fabiankung/MMU_FOE_Sensor_Node/README.md

# MMU_FOE_Sensor_Node
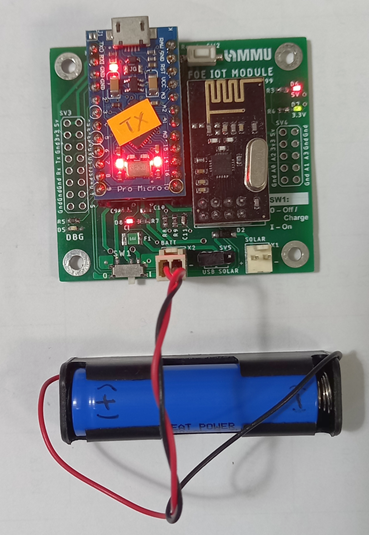
[picture p1: SensorNode_V0_99.bmp]
Sensor Node


A small sensor node design based on Arduino by Faculty of Engineering, Multimedia University.
Please go the the /Hardware_Build folder for the design details and also the quick start guide.
