fabiankung/MMU_FOE_Sensor_Node/Hardware_Build/V0_99/BOM_V0_99.xlsx

Bill Of Materials
Design Title |  |  | FOE IOT Node (Beta)
Author
Document Number
Revision |  |  | 0.99
Design Created
Verify |  |  | F.Kung
 | Components need to order
Category | Quantity | References | Value | Remarks/Description | Stock Code | Supplier | PCB Package
IC | 1 | U1 | MIC2288 | 2.5V-10Vin, 3.6V-34Vout, 1Aout, DC-DC regulator | 2509929 | Element14 | SOT-23-5 | Can replace with AP1603WG-7
Inductor | 1 | L1 | 4.7uH | 1.35A, Shielded power inductor | 3585795 | Element14 | 3x3 mm
Capacitor | 5 | C1, C5, C6, C9, C10 | 10uF | 6.3V, +-20% Multilayer ceramic | 3216467 | Element14 | 0603
Capacitor | 1 | C2 | 22uF | 6.3V, +-20% Multilayer ceramic | 2494232 | Element14 | 0603
Capacitor | 5 | C3, C4, C7, C8, C11 | 0.1uF | 50V, 10% Multi-layer ceramic | 2146610 | Element14 | 0603
Diodes | 3 | D1, D2, D3 | PMEG3010 | 30V, 1A Schottky rectifier | 2498556 | Element14 | SOD-993
Diodes | 1 | D4 | MMSZ5234BT1G | 6.2V, 500mW, 5% Zener single diode | 1431276 | Element14 | SOD-123
Resistor | 1 | R1 | 5.62k | 1%, 100mW, SMD Chip Resistor | 3540041 | Element14 | 0603
Resistor | 1 | R2 | 1.87k | 1%, 100mW, SMD Chip Resistor | 2694757 | Element14 | 0603
Resistor | 2 | R3, R7 | 4.7k | 1%, 62.5mW, thick film | 2447187 | Element14 | 0603
Resistor | 1 | R4 | 1.0k | 5%, 125mW, thick film | 9330380 | Element14 | 0603
LED | 1 | LED1 | 5V Red | Generic ultra bright LED | 2290329 | Element14 | 0603
LED | 1 | LED2 | 3V3 Green | Generic ultra bright LED | 8529833 | Element14 | 0603
IC | 1 | U2 | BU33TD3WG-TR | LDO voltage regulator, 1.7V to 6V input, fixed output 3.3 V/ 200mA | 2342950 | Element14 | SSOP5
IC | 1 | U3 | MCP73831T-2ATI/OT | Battery charger for a cell of Li-Ion | 1834890 | Element14 | SOT-23-5
Battery | 1 |  | 3.7V, 600mAh, 14500 | Li-Ion battery, 14500 size | LI-14500-600 | Cytron | NA
Solar panel | 1 |  | 5V, 200mA (1W) | THIS IS OPTIONAL | SC-05V-200MA | Cytron | NA
Resistor | 1 | R6 | 6.8k | 5%, 250mW, thick film | 1128052 | Element14 | 0603
Resistor | 2 | R8, R9 | 10k | 1%, 0.05W, thick film | 2349889 | Element14 | 0603
Fuse | 1 | F1 | 16V, 0.5A | Resettable PTC | 2848519 | Element14 | SMD
LED Products | 1 | Cl | 5V Red | Generic ultra bright LED | 2290329 | Element14
Pin Header | 1 | SV5 | NA | Straight Pin Header, Single Row (Male) | CN-PH-M140S | Cytron | 2.54mm
Switch | 1 | SW1 | SPDT switch | Slide Switch, SPDT, Surface Mount | 2854773 | Element14 | CUS-12B
Module | 1 | M1 | NA | Arduino Pro-Micro | ARD-PRO-MICROC | Cytron | NA
Pin Header | 1 | SV3, SV4 | NA | Straight Pin Header, Double Row (Male) | CN-PH-M240S | Cytron | 2.54mm
Female Header | 1 | SV1 | NA | Straight Female Header, Double Row | CN-PH-F210S | Cytron | 2.54mm
Connector | 2 | X1, X2 | NA | PCB Connector Header 2 Ways | CN-2600PS-02 | Cytron | 2.54mm
Resistor | 1 | R5 | 2.2k | 1%, 100 mW, thick film | 9330810 | Element14 | 0603
LED | 1 | DBG Blue | Blue | 20mA, 3.3 V, 465nm | 2217972 | Element14 | 0603
Module | 1 | nRF24L01+ | NA | 2.4GHz Digital Radio | RF-TRX-2.4G | Cytron | NA
 |  |  |  |  |  |  | Total
