fabiankung/MMU_FOE_Sensor_Node/Hardware_Build/V0_99/Schematic 0.99.pdf

A

A

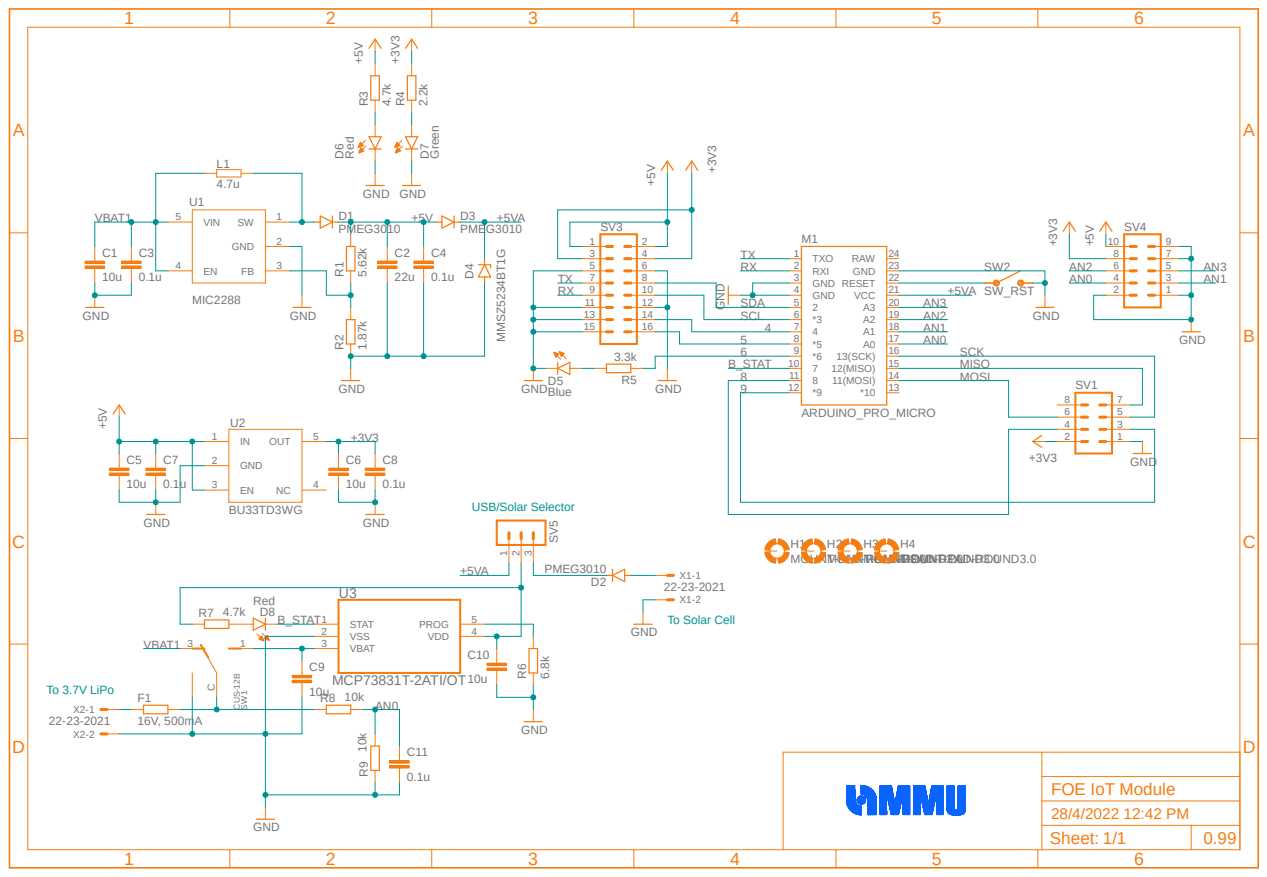
[picture p2: page 1]

15 | | 4 7 | ARDUINO_PRO_MICRO GND

13 | 14 | SCL
