fabiankung/MMU_FOE_Sensor_Node/Hardware_Build/Readme.md

## Sensor Node Schematic and PCB 
- Version: 0.99
- Date of design buy-off: 29 April 2022
- First batch build: 31 May 2022
