fabiankung/MMU_FOE_Sensor_Node/Hardware_Build/V0_99/PCB 0.99.docx

Top Copper

Bottom Copper

Silkscreen

Specify location for manufacturer order number. Or pay extra USD1.70 to remove it.

Dimension
