fabiankung/MMU_FOE_Sensor_Node/Hardware_Build/V0_99/QuickStartGuide.pdf

# FOE SENSOR NODE

# Version 0.99 (Initial Release A)

# QUICK START GUIDE (REV A0)

22/5/2023 | 1

# Simplified Block Diagram (V0.90 and V0.99)

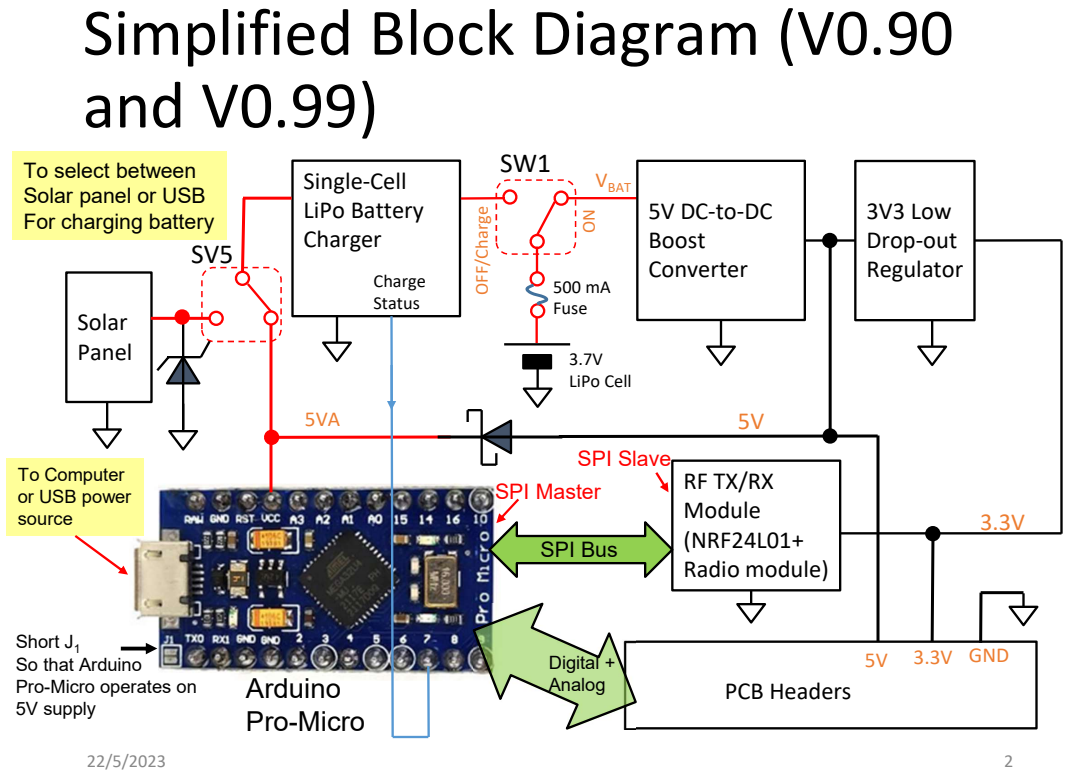
[picture p3: page 2]
Single-Cell LiPo Battery Charger; 3V3 Low Drop-out Regulator; 3.7V LiPo Cell; PCB Headers; Solar Panel; 5V 3.3V GND; SPI Bus; SPI Master; SPI Slave; Digital + Analog; 500 mA Fuse; Charge Status; Arduino Pro-Micro

SW1 ON OFF/Charge

To select between
Solar panel or USB
For charging battery

VBAT
Boost
Converter

To Computer
or USB power
source

Module
(NRF24L01+
Radio module)

Short J1
So that Arduino
Pro-Micro operates on
5V supply

# Features

- Arduino based (Arduino Pro-Micro).
- Low power, 3.0 to 12.0 V input voltage to power the device.

# - 4 Analog and 5 digital I/O pins, with 5V and 3.3V supply for interfacing with various sensors (Note: Analog pin A0 is used

for monitoring input supply voltage).

# - Secure 2.4 GHz RF link between sensor nodes and a Master

node cum Internet gateway (10-20m).

# - Rechargeable lithium polymer (LiPo) battery, battery can be

charged via micro-USB receptable or optional solar panel.

22/5/2023 | 3

# Specifications

- Main Controller: Arduino Pro-Micro.

# - Wireless Module: NRF24L01+ digital radio, 0.0 dBm

EIRP with 2 Mbps data rate using GMSK modulation, 2.400-2.4835 GHz ISM band.
- Analog input pins rating: 0-5V.
- Digital input/output pins: 0-5V, 25 mA source/sink.
- Battery: Rechargeable 3.7V LiPo cell, 100 - 1500 mAH.
- Charging options: Micro-USB port or Solar Panel.
- Indicators: Debug LED, 5V supply LED, 3.3V supply LED.

# - Dimensions: 55 x 50 x 20 mm

22/5/2023 | 4

Gaussian Minimum Shift Keying (a variant of FSK with no phase discontinuity)

# Detailed Schematic

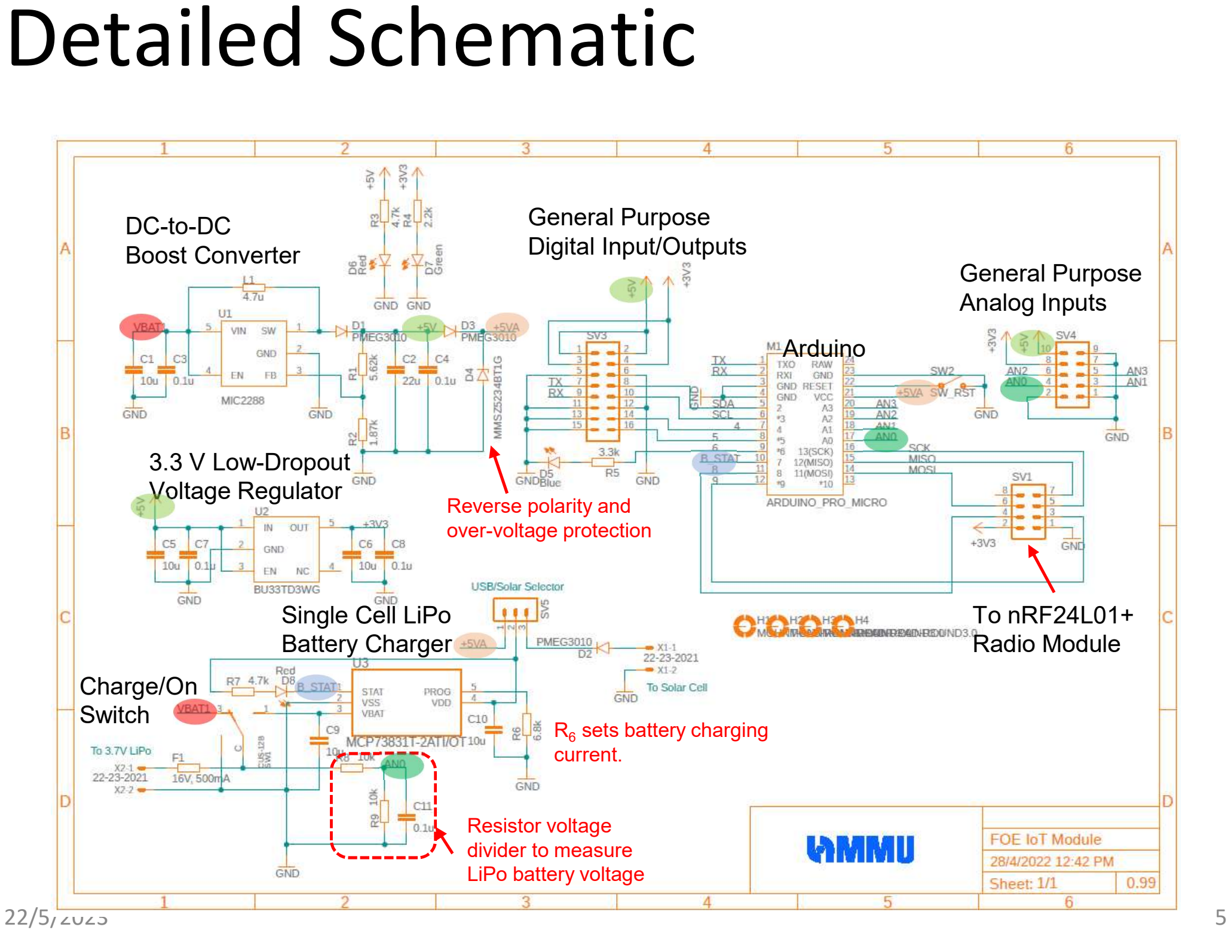
[picture p4: page 5]

22/5/2023 | 5

DC-to-DC
Boost Converter

### 3.3 V Low-Dropout

Voltage Regulator

Single Cell LiPo
Battery Charger
Charge/On
Switch

To nRF24L01+
Radio Module

Arduino

Resistor voltage
divider to measure
LiPo battery voltage

R6

sets battery charging
current.

Reverse polarity and
over-voltage protection

General Purpose
Analog Inputs

General Purpose
Digital Input/Outputs

# A Fully-Assembled Board

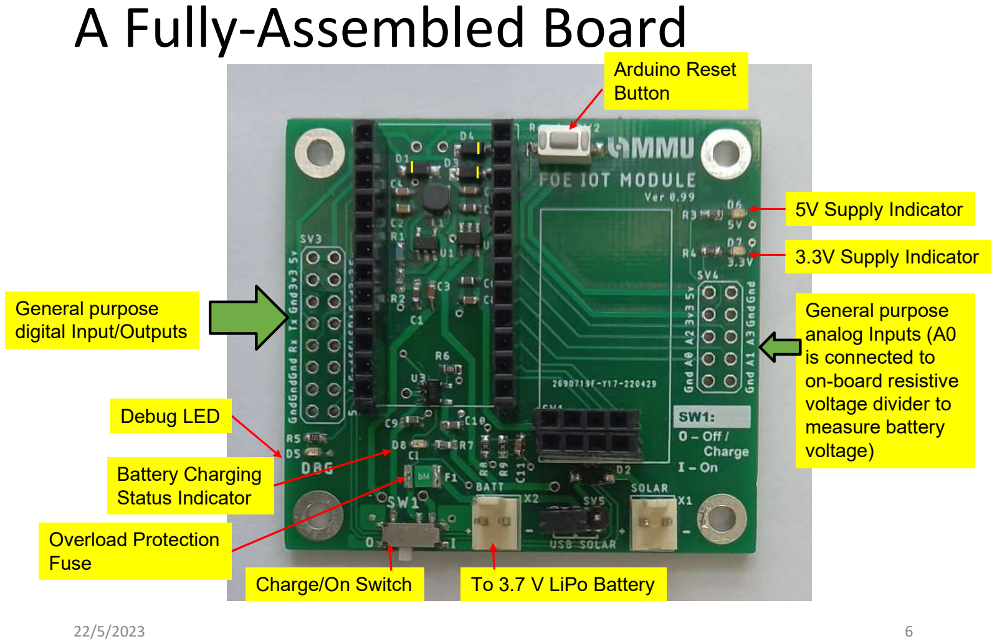
[picture p5: page 6]

22/5/2023 | 6

Arduino Reset
Button

Charge/On Switch To 3.7 V LiPo Battery

Debug LED

5V Supply Indicator

3.3V Supply Indicator

Battery Charging
Status Indicator

Overload Protection
Fuse

General purpose
analog Inputs (A0
is connected to
on-board resistive
voltage divider to
measure battery
voltage)

General purpose
digital Input/Outputs

# Fully Assembled Board with Arduino Pro-Micro and nRF24L01+ Radio

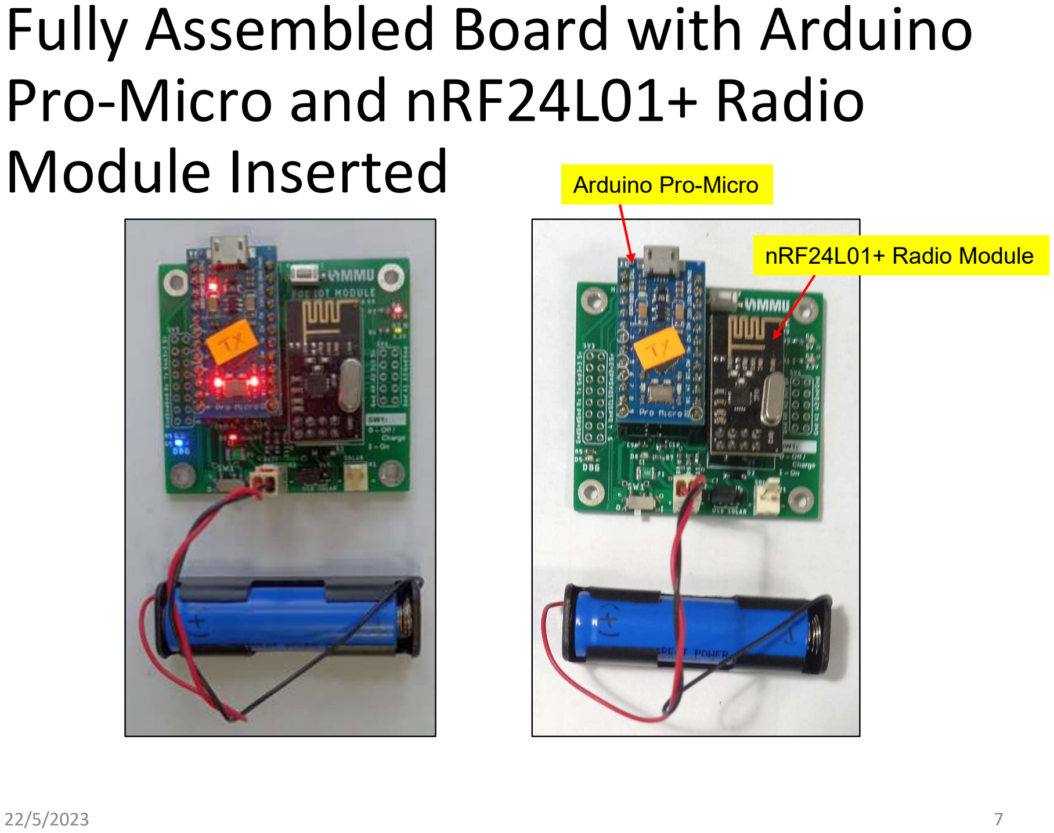
[picture p6: page 7]

# Module Inserted

22/5/2023 | 7

Arduino Pro-Micro

nRF24L01+ Radio Module

# Normal Operation (On)

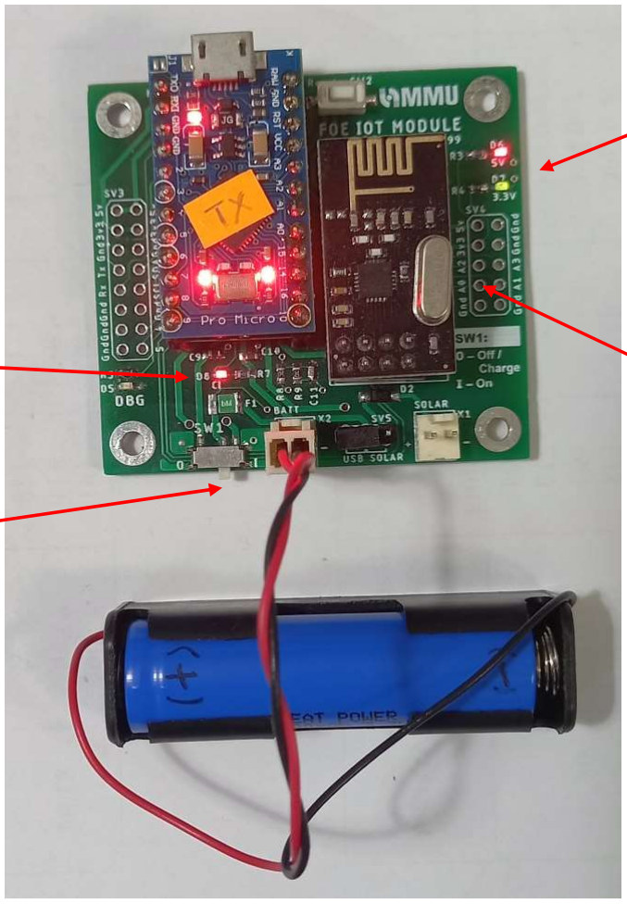
[picture p7: figure]

22/5/2023 | 8

Both supply indicator
LEDs should light up

Analog pin A0 indicates battery Voltage level via a divide-by-2 Resistor network.
For example if battery voltage is

### 3.7 V, pin A0 voltage should be

1.85 V.

SW1 to ‘On’
position

Can ignore battery
charging status
Indicator during normal
operation

# Charging LiPo Battery Via USB Port

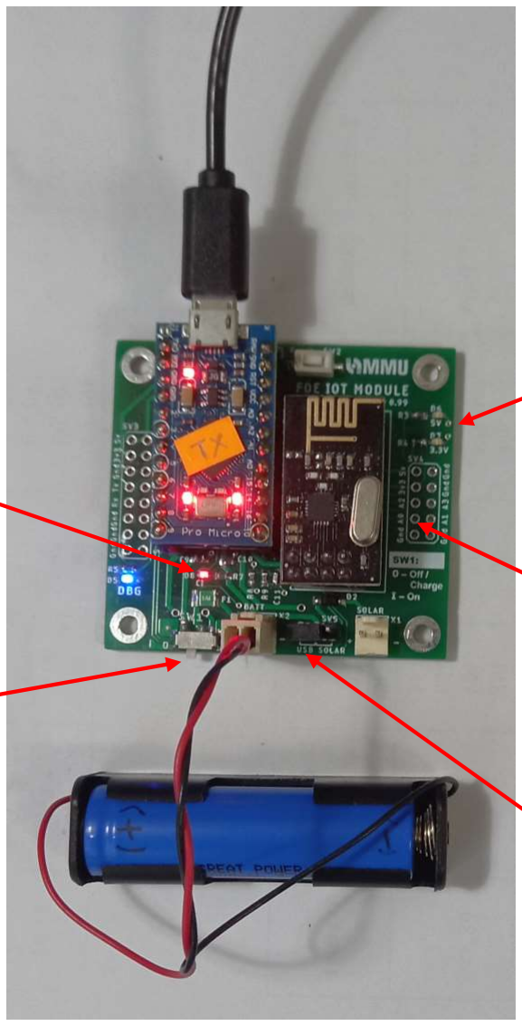
[picture p8: figure]

22/5/2023 | 9

Both supply indicator
LEDs should not light up

Analog pin A0 indicates battery Voltage level via a divide-by-2 Resistor network.
For example if battery voltage is

### 3.7 V, pin A0 voltage should be

1.85 V.

SW1 to ‘Off/Charge’
position

Battery
charging status
Indicator will lights up
during charging and
turned off when fully
Charged
(Max charging current is
200 mA)

Note the position of jumper SV5

# Charging LiPo Battery via Solar Panel

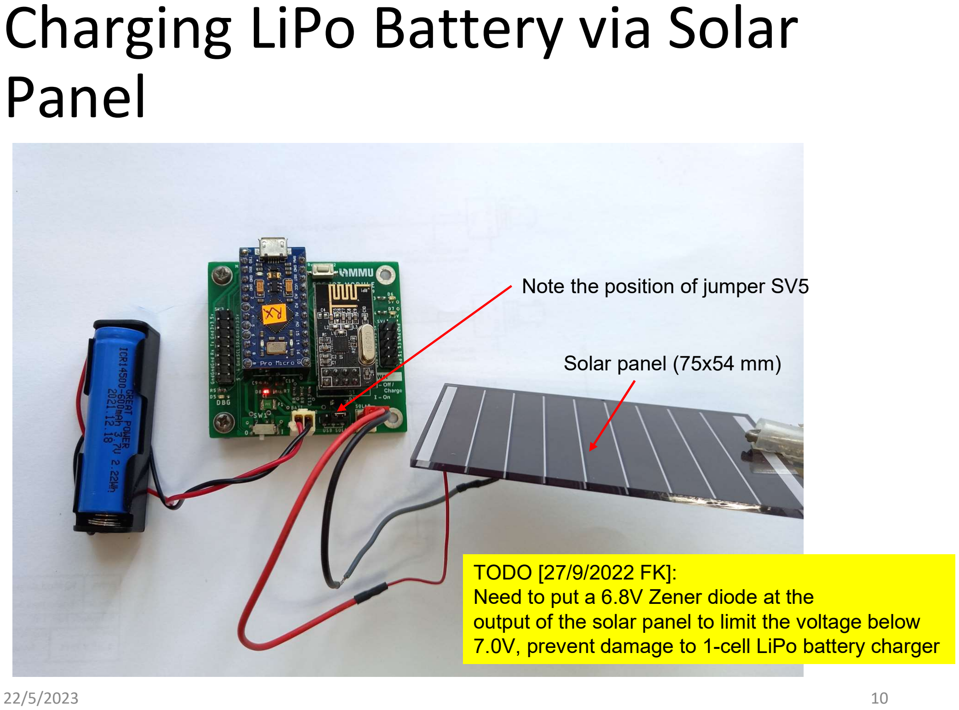
[picture p9: page 10]

22/5/2023 | 10

Note the position of jumper SV5

TODO [27/9/2022 FK]:
Need to put a 6.8V Zener diode at the
output of the solar panel to limit the voltage below 7.0V, prevent damage to 1-cell LiPo battery charger

Solar panel (75x54 mm)

# APPENDIX

22/5/2023 | 11

# Basic Functional Test for Newly Assembled PCB (1 off 2)

# - 1. Do not connect any wires or battery to the IOT

board.
- 2. Set Switch SW1 to “0 - Off/Charge” position.
- 3. Connect USB port of Arduino module to computer.

# - 4. Load the firmware “Wireless_TX_Basic.ino” into

the Arduino module.

# - 5. If the firmware is successfully loaded and IOT board no hardware error, LED “DBG” should blink at 2 Hz rate. Also LED D8

should lights up.

22/5/2023 | 12

# Basic Functional Test for Newly Assembled PCB (1 off 2)

# - 6. Now connect the LiPo battery to PCB header X2

(Batt),

# LED D8

# should continues to light up indicating that the LiPo

battery is being charged.
- 7.LED D8 would turn off when LiPo battery is fully charged.
- 8. Once the LiPo battery is partially charged for 15 minutes, set switch SW1 to “I – On” position.

# - LEDs 3.3 V (D7

# ) and 5.0 V (D6

# ) should light up, indicating presence

of 3.3 V and 5.0 V supplies to the system.
- LED “DBG” should continues to blink.

# - LED D8

should not turn on.
- 9. Now the IOT module should be ready for use.
22/5/2023 | 13

# Debug Tips

# - As the nRF24L01+ radio module does not have any indicator LED, we would need to probe it’s pin with digital oscilloscope to check if the Arduino is

communicating with the radio module.

# - Under normal operations:

- MOSI pin should be logic high.
- MISO pin should contain digital data.
- SCK pin should have burst of 8-pulses.
- CSN pin should alternate between logic high and low.
- CE pin should be logic high (enable the radio module).
22/5/2023 | 14

# nRF24L01 2.4 GHz Radio Chip

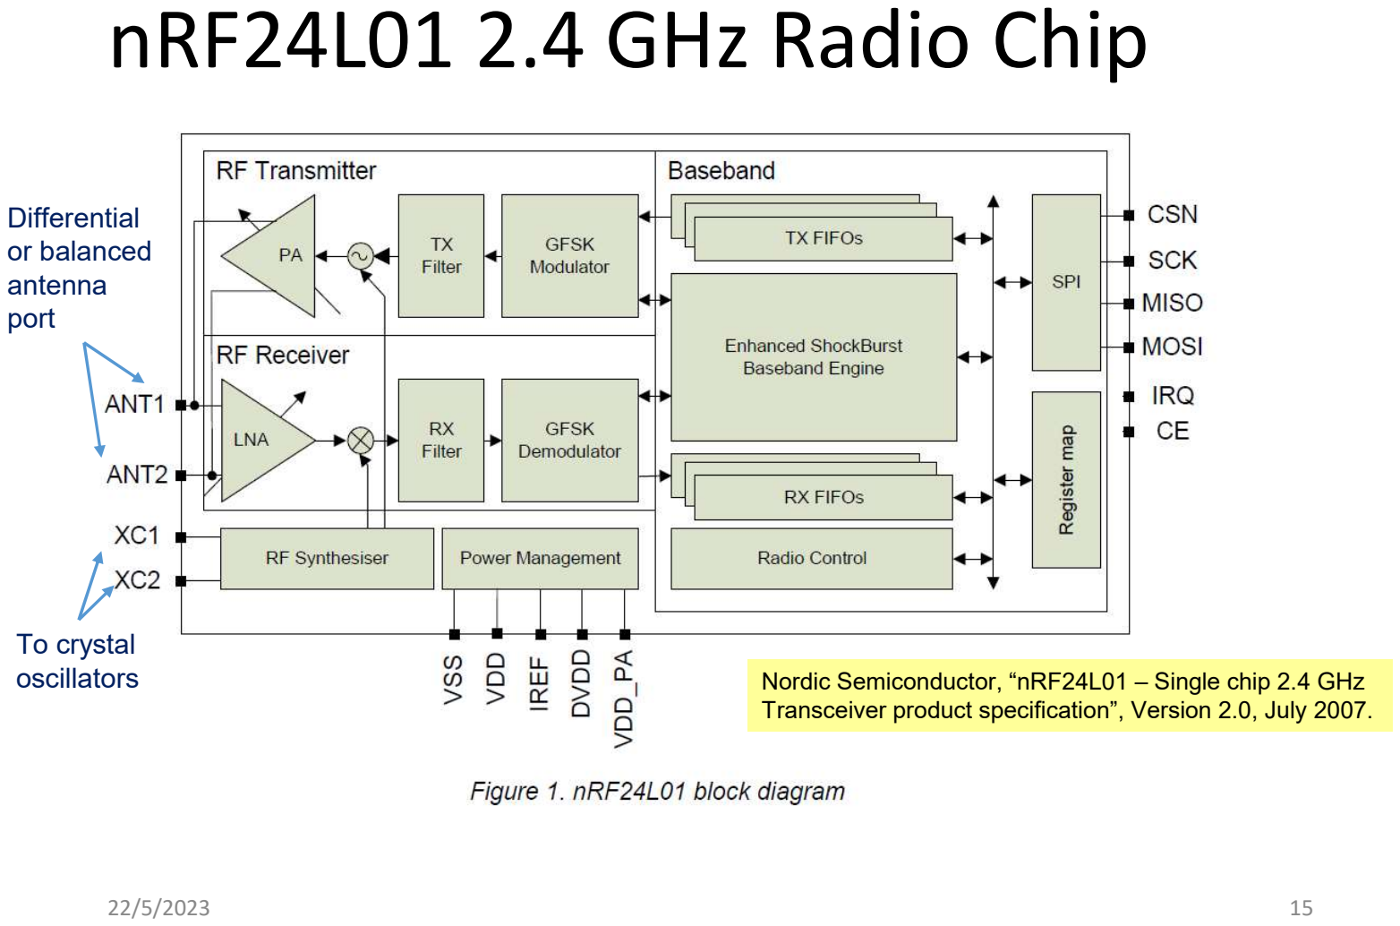
[picture p10: page 15]

22/5/2023 | 15

Nordic Semiconductor, “nRF24L01 – Single chip 2.4 GHz Transceiver product specification”, Version 2.0, July 2007.

Differential
or balanced
antenna
port

To crystal
oscillators

# nRF24L01 Serial Peripheral Interface (SPI) (1 of 2)

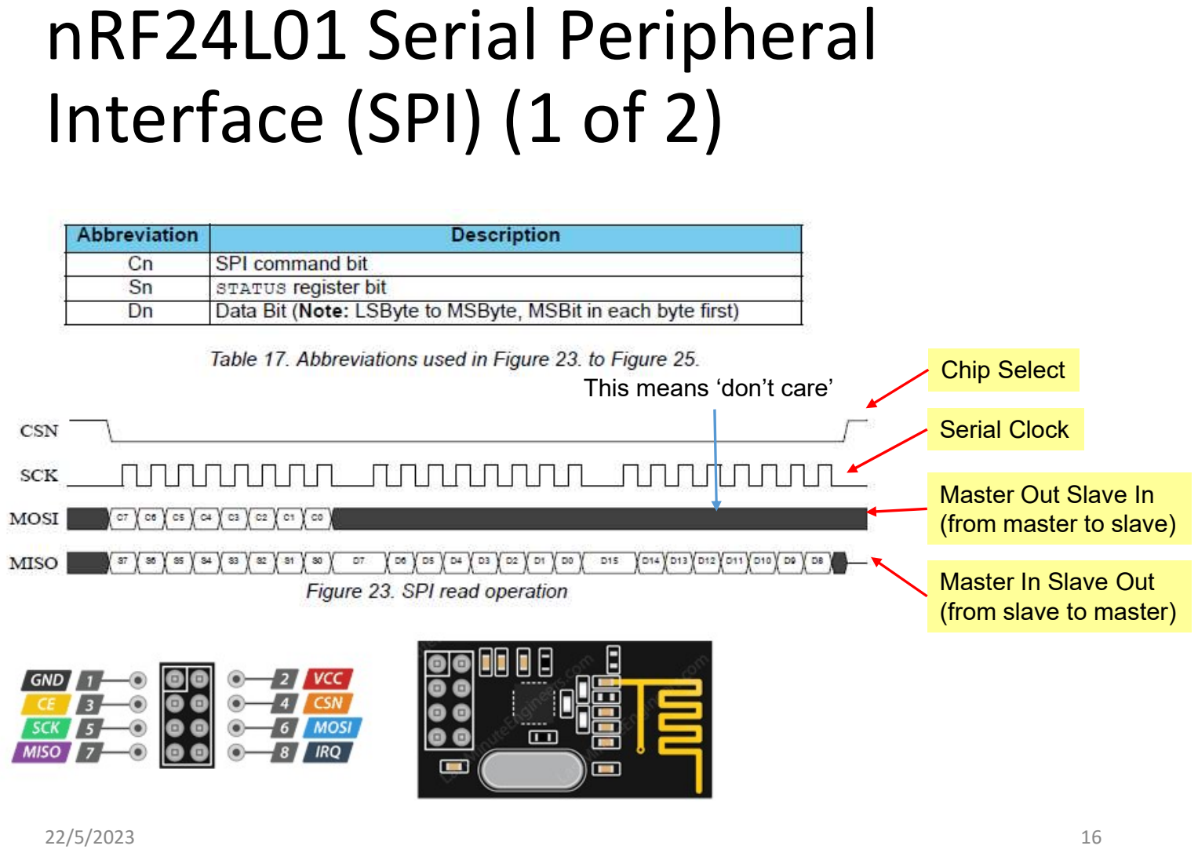
[picture p11: page 16]

22/5/2023 | 16

Serial Clock

Master Out Slave In
(from master to slave)

Chip Select

Master In Slave Out
(from slave to master)

This means ‘don’t care’

# nRF24L01 Serial Peripheral Interface (SPI) (2 of 2)

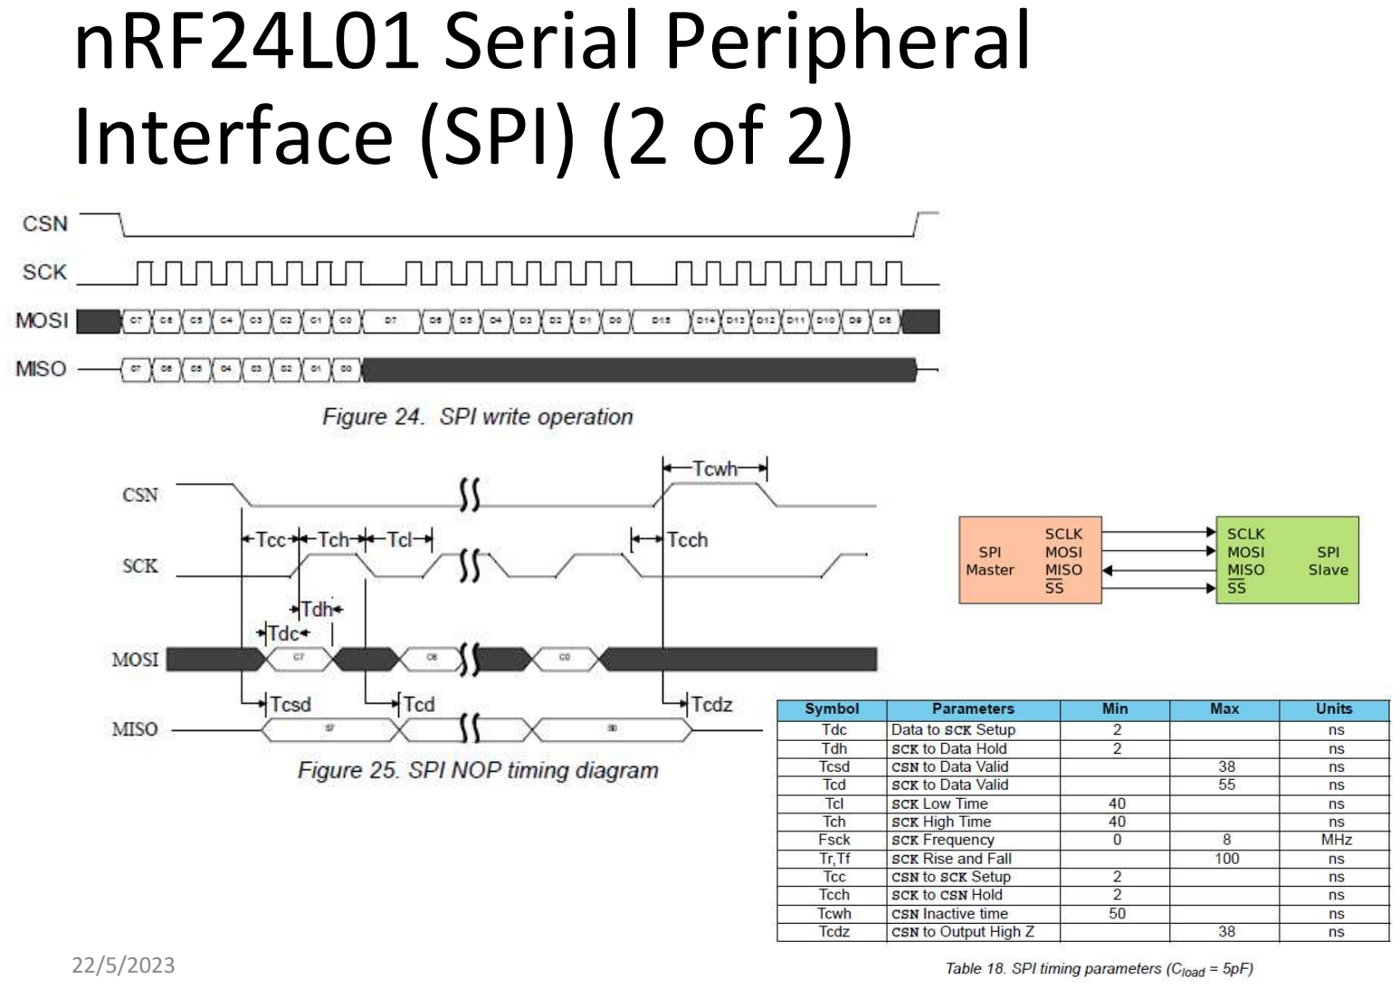
[picture p12: page 17]

22/5/2023 | 17

# Sample Schematic of nRF24L01 Radio Module

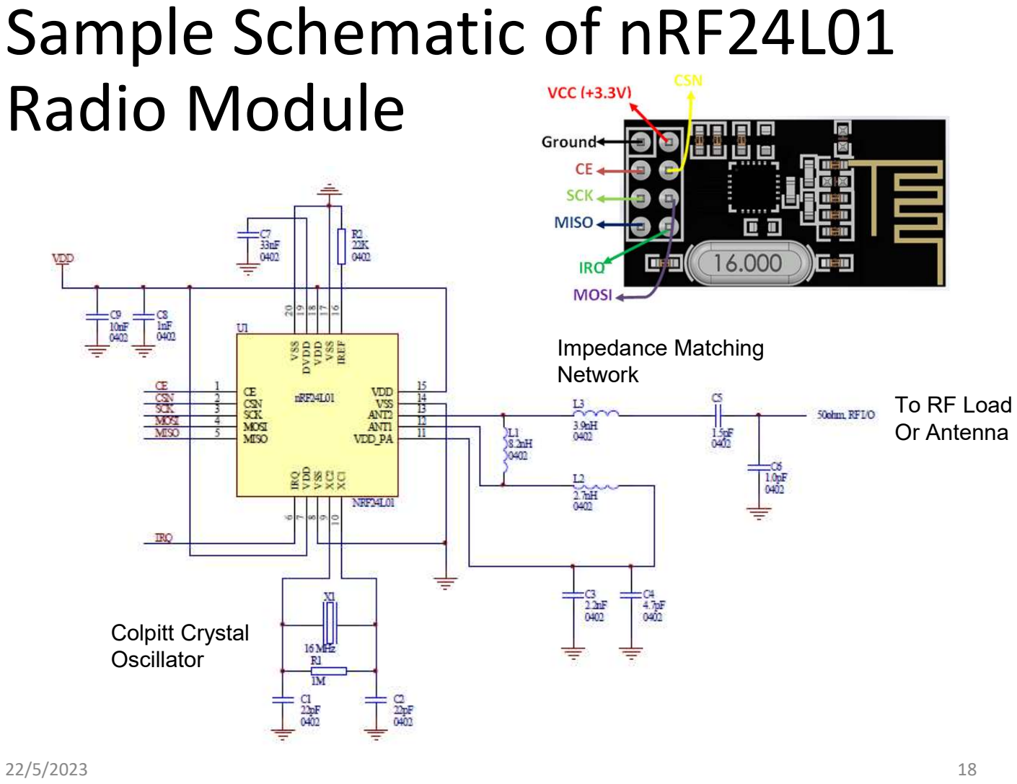
[picture p13: page 18]

22/5/2023 | 18

Colpitt Crystal
Oscillator

Impedance Matching
Network
To RF Load
Or Antenna

# Suggested Component List

- Capacitive based analog soil moisture sensor (MAKER-SOIL-MOISTURE) x 3 - https://my.cytron.io/c-sensor/c-liquid-flow-ph-sensor/p-grove-capacitive-soil-moisture-sensor-corrosion-resistant (RM30) or - https://my.cytron.io/c-sensor/c-liquid-flow-ph-sensor/p-maker-soil-moisture-sensor (RM20) - Ambient light sensor (SN-LIGHT-MOD) x 3 - https://my.cytron.io/c-sensor/c-optical-infrared-sensor/p-light-sensor-module (RM5) - DHT22 ambient humidity and temperature sensor (SN-DHT22-MOD) x 2 - https://my.cytron.io/p-dht22-sensor-module-breakout (RM16) - Brushed DC motor driver (MAKER-DRIVE) x 2 - https://my.cytron.io/p-maker-drive-simplifying-h-bridge-motor-driver-for-beginner (RM20)

22/5/2023 | 19

Quantity
